jotonedev/weather-station/pictures/air-sensor-box/PXL_20260928_095529061.webp

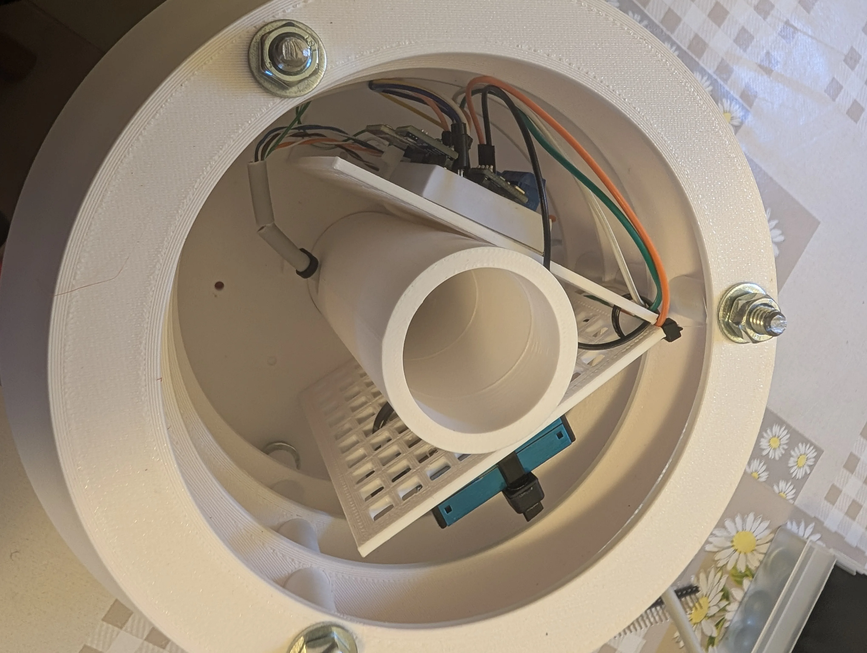
pictures/air-sensor-box/PXL_20260928_095529061.webp
