jotonedev/weather-station/pictures/rain-gauge/PXL_20260929_161344346.webp

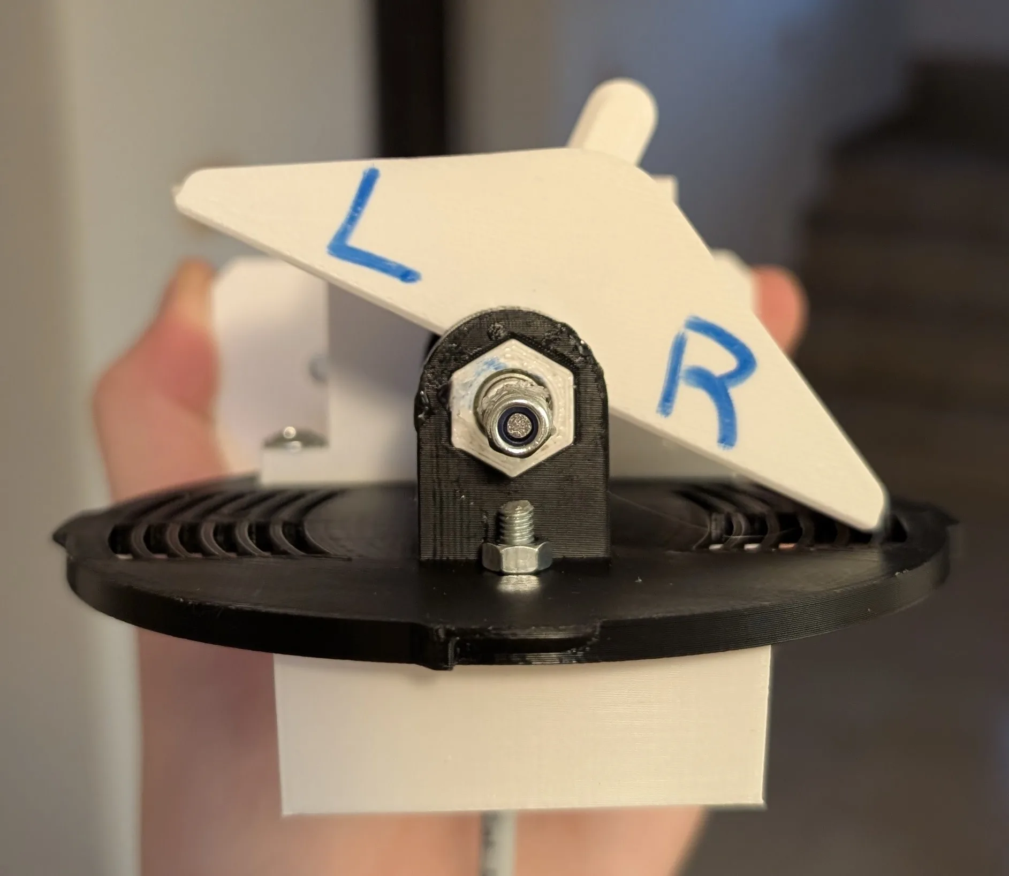
pictures/rain-gauge/PXL_20260929_161344346.webp
