jotonedev/weather-station/3dmodels/air-sensor-box/README.md

Remix of https://www.printables.com/model/1007462-sensor-community-airrohr-stevenson-screen
