jotonedev/weather-station/pictures/air-sensor-box/PXL_20260925_132656194.webp

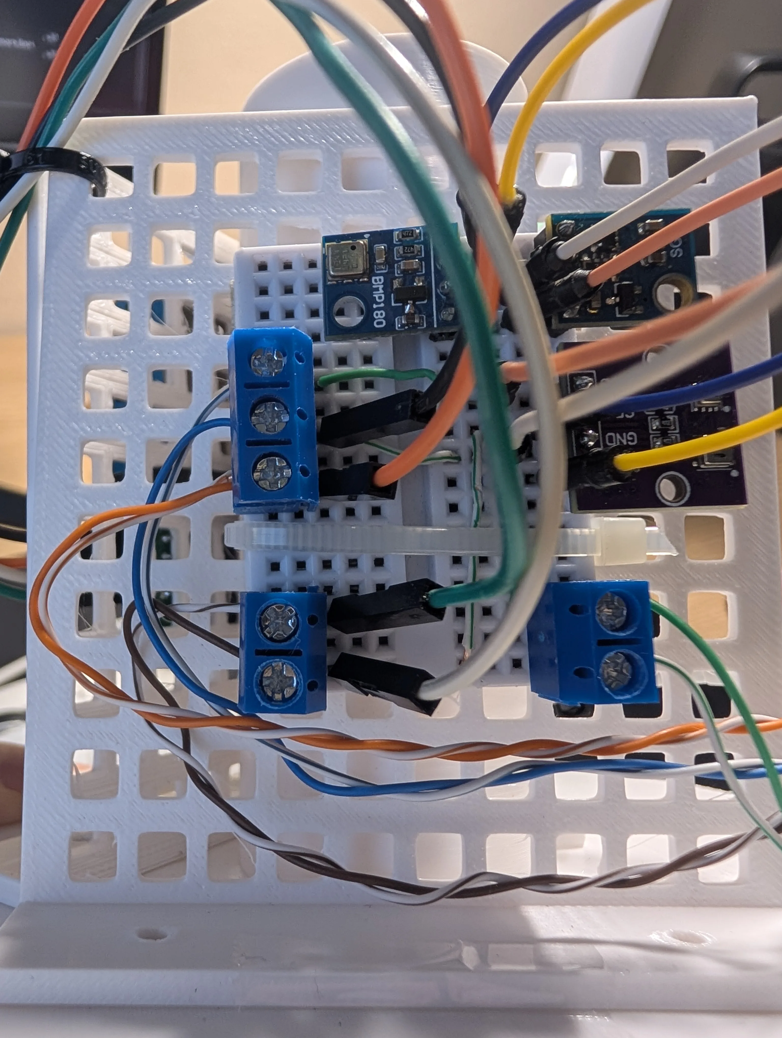
pictures/air-sensor-box/PXL_20260925_132656194.webp
