jotonedev/weather-station/pictures/air-sensor-box/PXL_20260928_095535636.webp

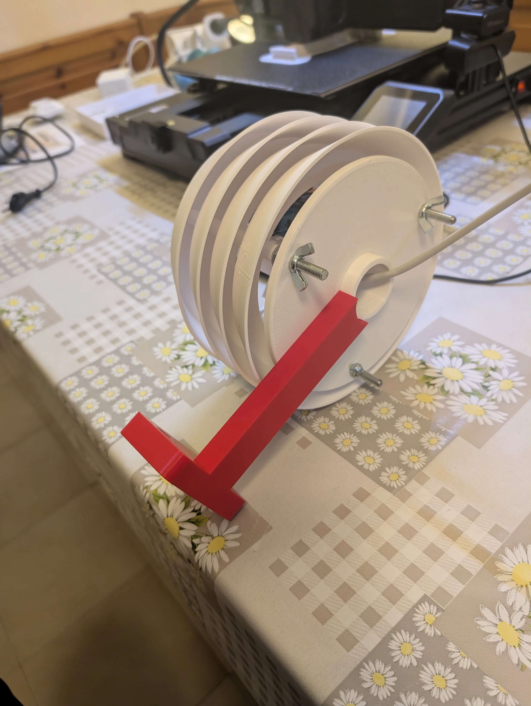
pictures/air-sensor-box/PXL_20260928_095535636.webp
