jotonedev/weather-station/pictures/anemometer-windvane/PXL_20260923_092408373.webp

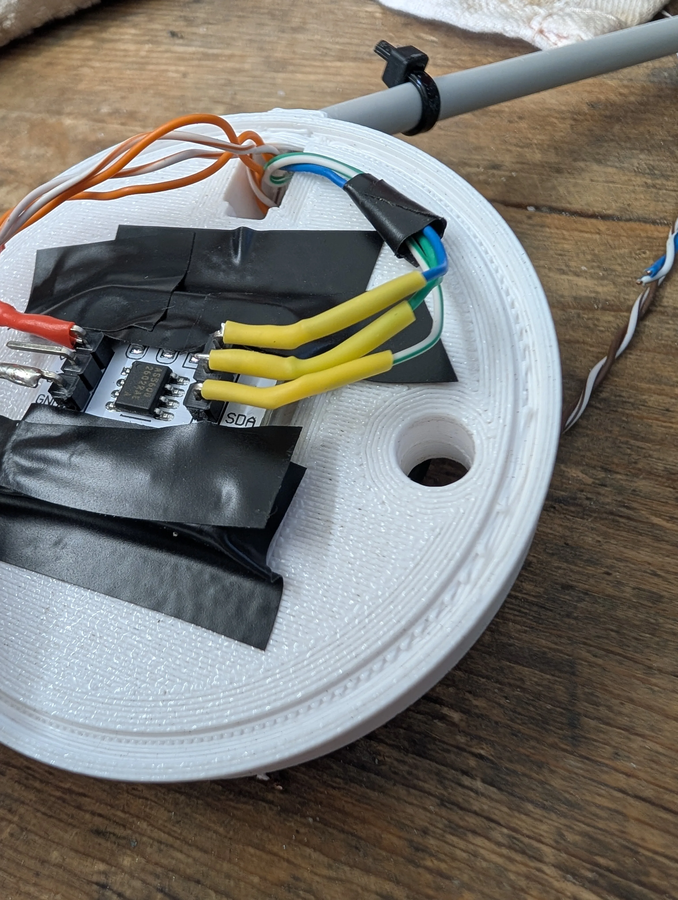
pictures/anemometer-windvane/PXL_20260923_092408373.webp
