jotonedev/weather-station/pictures/anemometer-windvane/PXL_20260928_095719903.webp

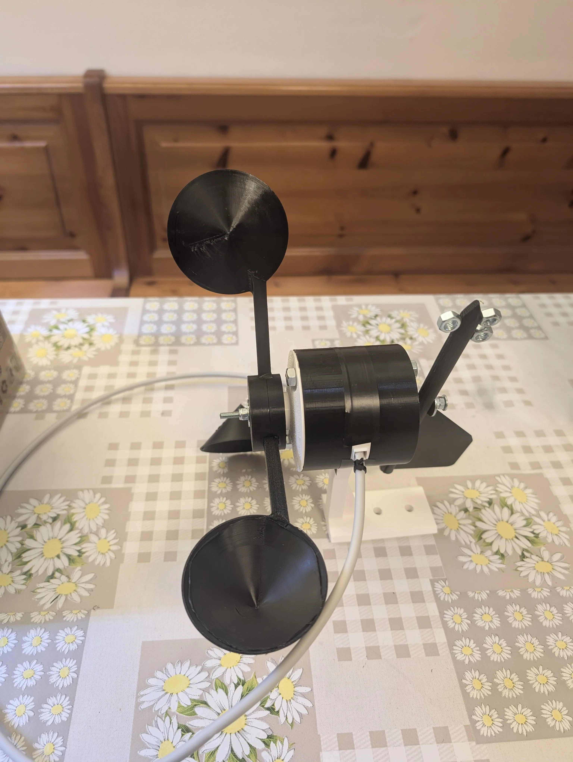
pictures/anemometer-windvane/PXL_20260928_095719903.webp
