jotonedev/weather-station/pictures/rain-gauge/PXL_20260929_145509552.webp

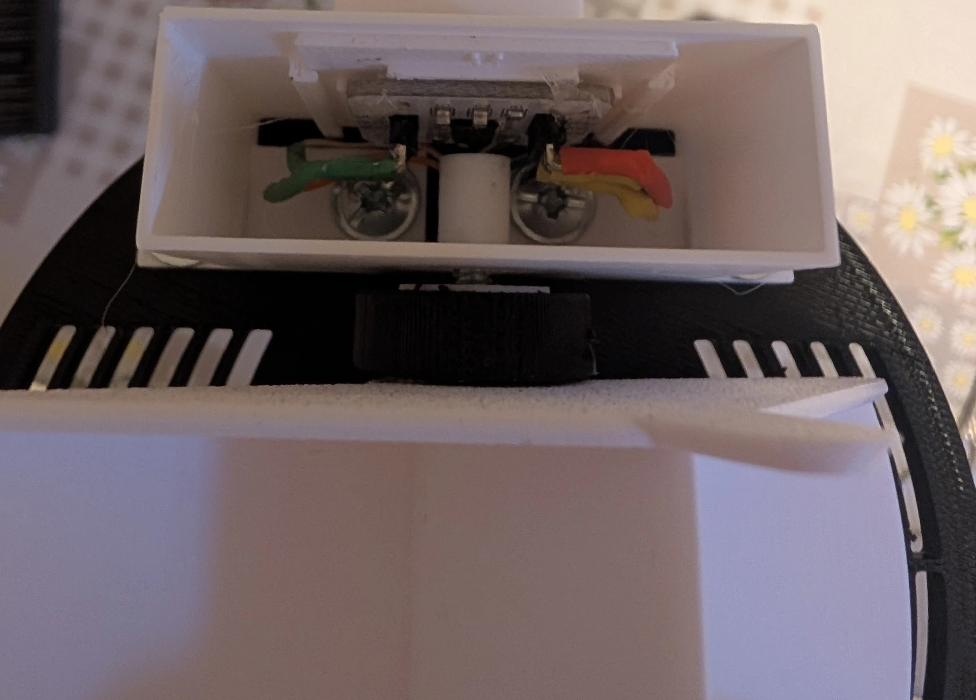
pictures/rain-gauge/PXL_20260929_145509552.webp
