jotonedev/weather-station/pictures/rain-gauge/PXL_20260929_161341023.webp

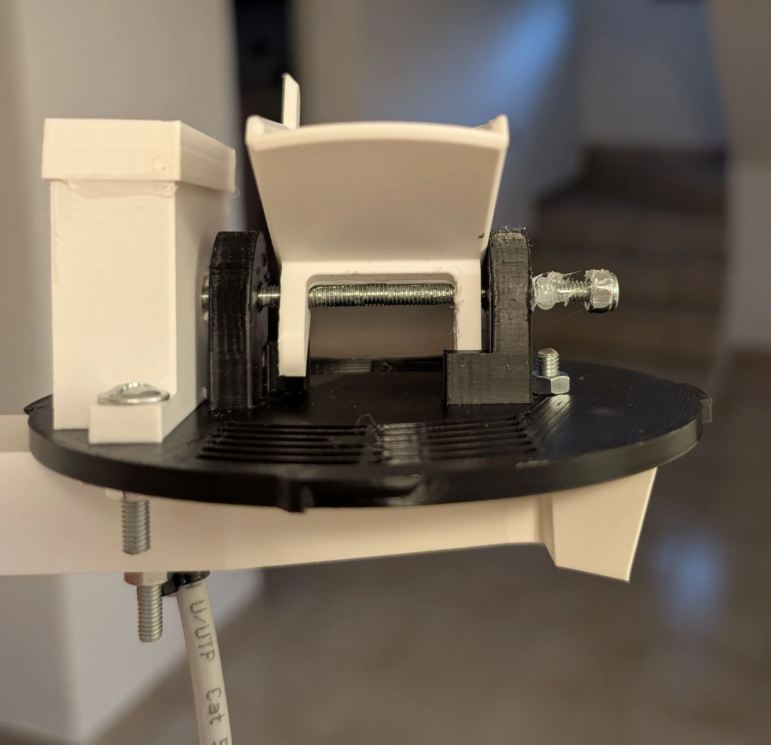
pictures/rain-gauge/PXL_20260929_161341023.webp
