jotonedev/weather-station/pictures/web-interface/homepage-01.webp

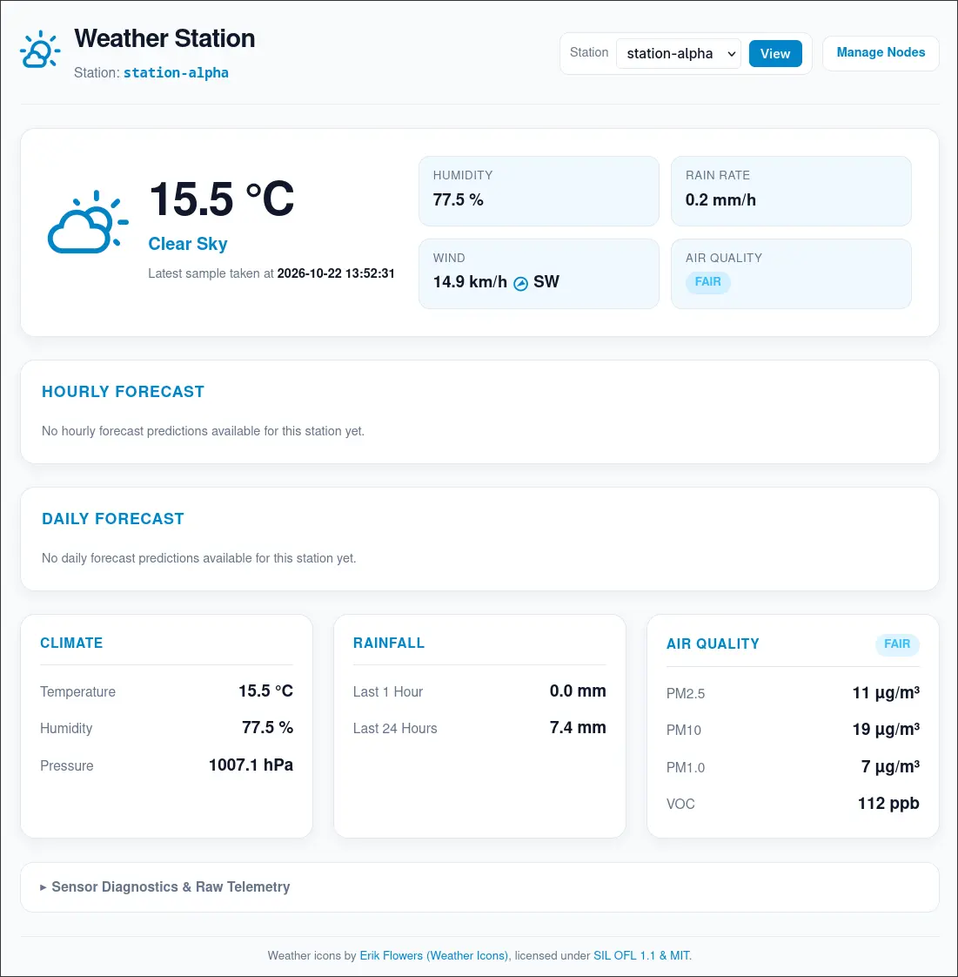
pictures/web-interface/homepage-01.webp
