jotonedev/weather-station/3dmodels/air-sensor-box/air-sensor-box.3mf

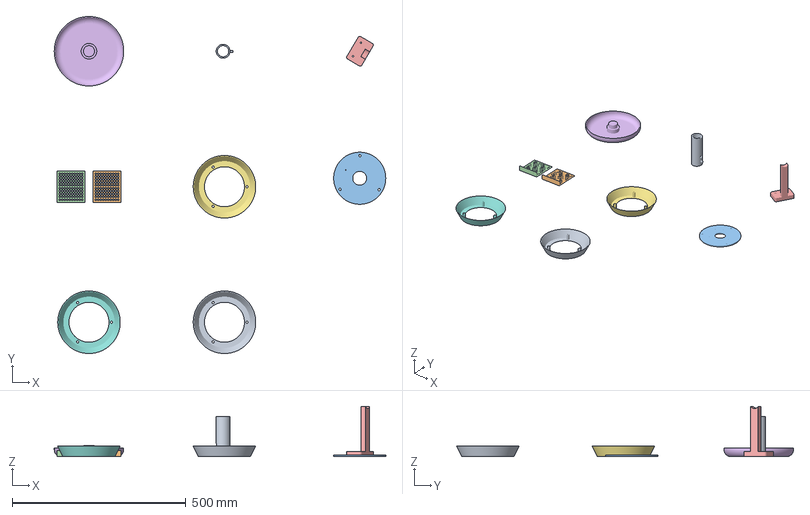
[picture p10: CAD file, 2026-10-08]
3dmodels/air-sensor-box/air-sensor-box.3mf
954.2 x 970.0 x 144.7 mm
airrohr-case-v41_airrohr-case-v41_Body7.stl
airrohr-case-v41_airrohr-case-v41_Body15.stl x 2
Body35.stl
airrohr-case-v41_airrohr-case-v41_Body34.stl
Body22.stl
layer-weather-shield.stl x 3
