jotonedev/weather-station/3dmodels/air-sensor-box/stl/air sensor box_air sensor box_wall_3_Body1.stl

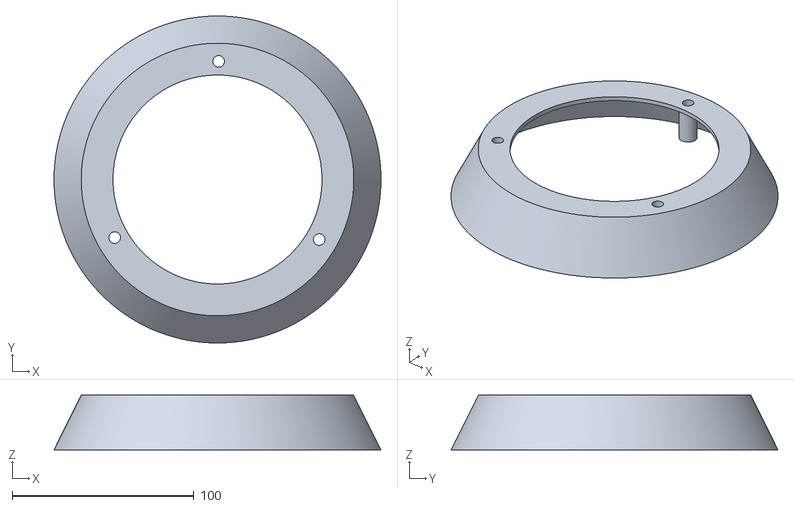
[picture p11: CAD file, 2026-10-08]
3dmodels/air-sensor-box/stl/air sensor box_air sensor box_wall_3_Body1.stl
180.0 x 180.0 x 30.0
