jotonedev/weather-station/3dmodels/anemometer-windvane/anemometer-windvane.3mf

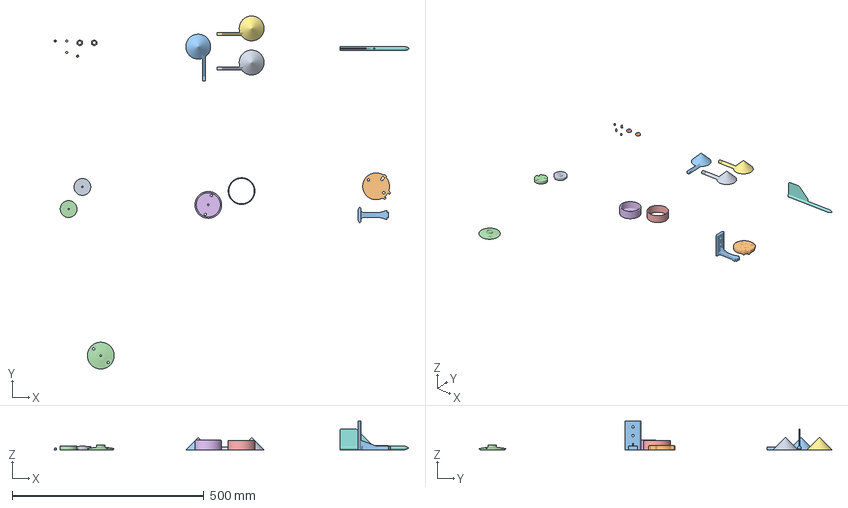
[picture p12: CAD file, 2026-10-08]
3dmodels/anemometer-windvane/anemometer-windvane.3mf
925.8 x 921.3 x 75.0 mm
Anemometre+Girouette_Anemometre+Girouette_anemometro_1_Support Helice Inf_1_Support Helice Inf.stl
Anemometre+Girouette_Anemometre+Girouette_base_1_Liaison Centrale.stl
Anemometre+Girouette_Anemometre+Girouette_supporto_1_Body1.stl
Anemometre+Girouette_Anemometre+Girouette_anemometro_1_Anemometre - Couvercle Sup_1_Anemometre - Couvercle Sup.stl
Anemometre - boitier.stl
Girouette - boitier.stl
Coupelle Conique.stl x 3
Anemometre+Girouette_Anemometre+Girouette_banderuola_1_Girouette - Corps 2_1_Girouette - Corps 2.stl
Anemometre+Girouette_Anemometre+Girouette_banderuola_1_Cage roulement ajustée_1_Body1.stl
Anemometre+Girouette_Anemometre+Girouette_anemometro_1_Support Helice Sup_1_Support Helice Sup.stl
Anemometre+Girouette_Anemometre+Girouette_anemometro_1_Cage roulement ajustée_2_Body1.stl
supporto magnete.stl x 2
Anemometre+Girouette_Anemometre+Girouette_anemometro_1_spacer_3_Body1.stl
Anemometre+Girouette_Anemometre+Girouette_banderuola_1_spacer_4_Body1.stl
