jotonedev/weather-station/3dmodels/anemometer-windvane/stl/Anemometer_Anemometer_anemometro_1_Support Helice Sup_1_Support Helice Sup.stl

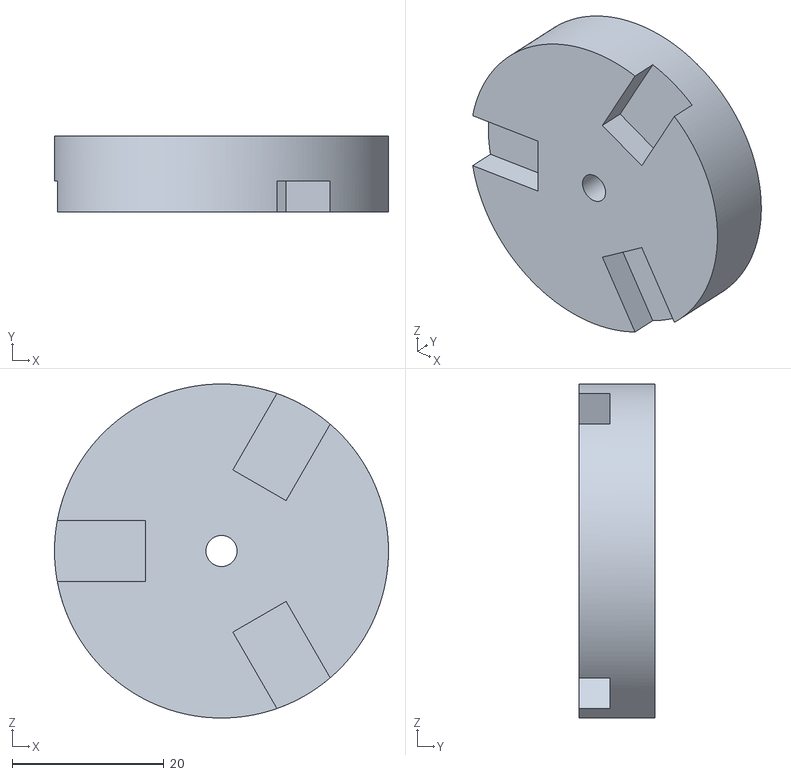
[picture p13: CAD file, 2026-10-08]
3dmodels/anemometer-windvane/stl/Anemometer_Anemometer_anemometro_1_Support Helice Sup_1_Support Helice Sup.stl
44.0 x 10.0 x 44.0
