jotonedev/weather-station/3dmodels/rain-gauge/rain-gauge.3mf

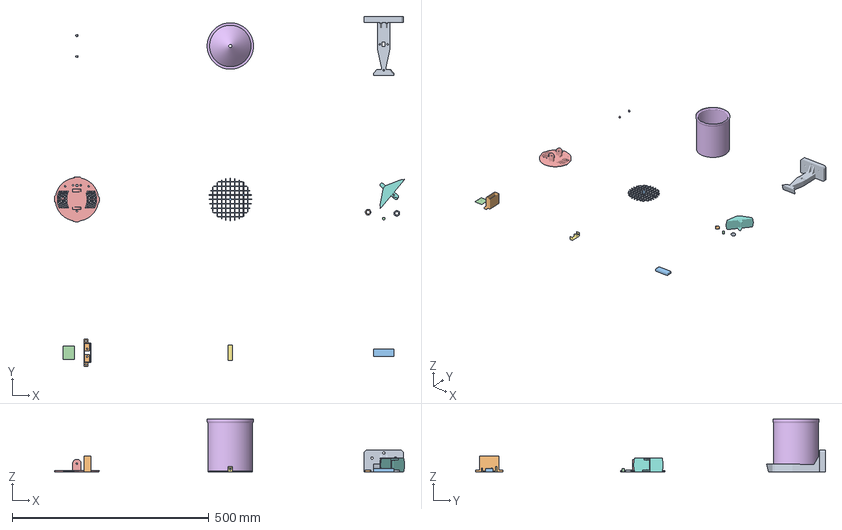
[picture p14: CAD file, 2026-10-08]
3dmodels/rain-gauge/rain-gauge.3mf
889.8 x 890.2 x 134.0 mm
Support.stl
walls.stl
cap.stl
as5600.stl
fixture.stl x 2
Body12.stl
Tipping bucket.stl
Body2.stl x 2
Mesh.stl
supporto magnete.stl
Base.stl
Case.stl
