jotonedev/weather-station/3dmodels/rain-gauge/stl/Rain gauge_Rain gauge_Roulement_1_housing.stl

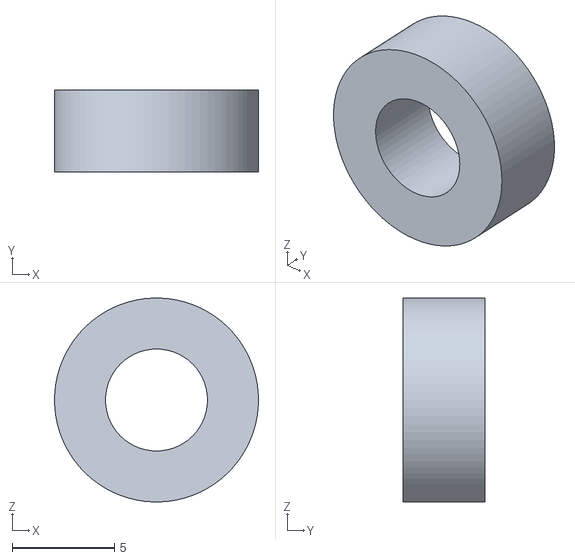
[picture p15: CAD file, 2026-10-08]
3dmodels/rain-gauge/stl/Rain gauge_Rain gauge_Roulement_1_housing.stl
10.0 x 4.00 x 9.99
