jotonedev/weather-station/3dmodels/air-sensor-box/stl/air sensor box_air sensor box_sensor-support_2_sensor-support.stl

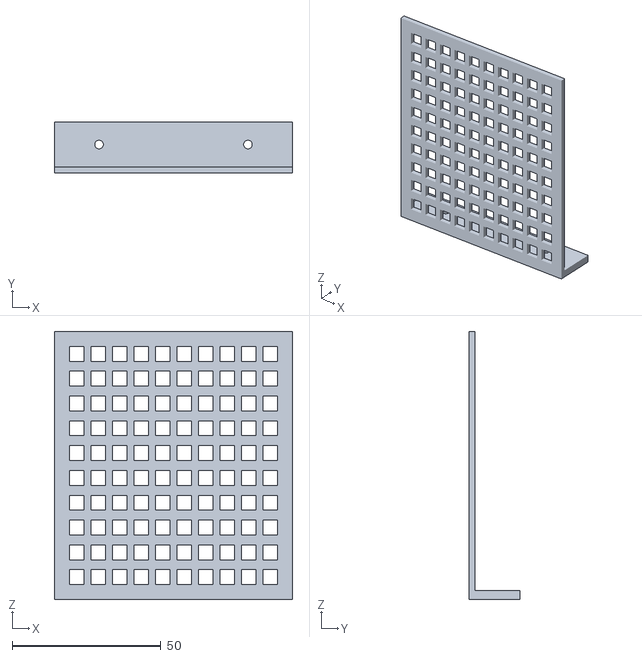
[picture p16: CAD file, 2026-10-08]
3dmodels/air-sensor-box/stl/air sensor box_air sensor box_sensor-support_2_sensor-support.stl
80.0 x 17.0 x 90.0
