jotonedev/weather-station/3dmodels/anemometer-windvane/stl/Anemometer_Anemometer_barre filettate_1_Body2.stl

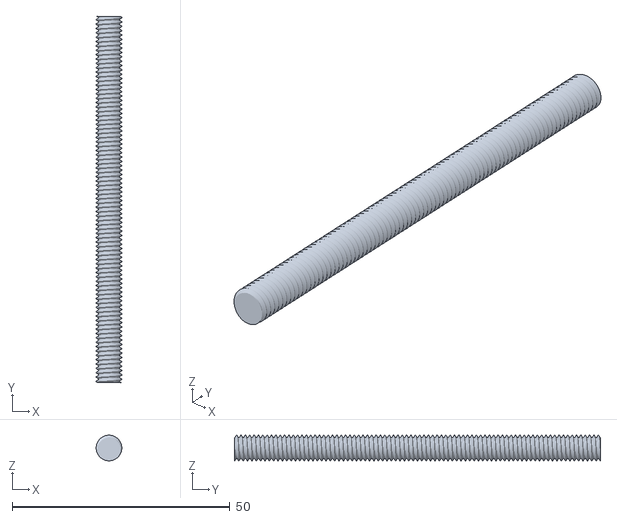
[picture p17: CAD file, 2026-10-08]
3dmodels/anemometer-windvane/stl/Anemometer_Anemometer_barre filettate_1_Body2.stl
5.88 x 84.0 x 5.88
