jotonedev/weather-station/3dmodels/rain-gauge/stl/Rain gauge_Rain gauge_Support_1_Base.stl

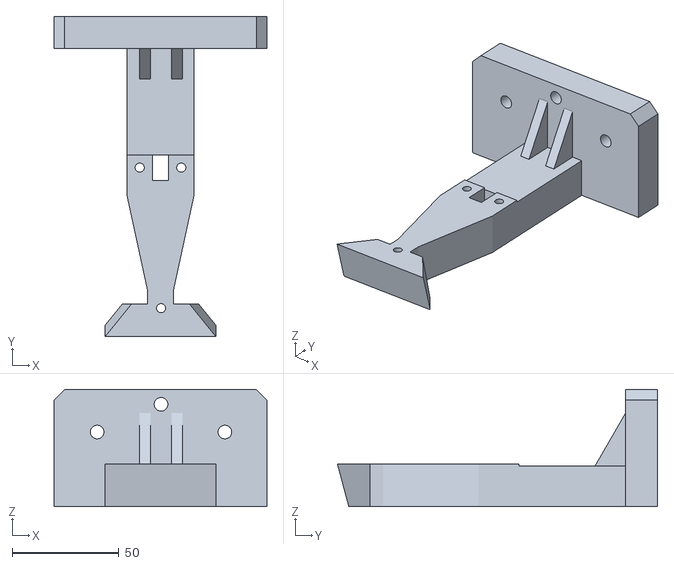
[picture p18: CAD file, 2026-10-08]
3dmodels/rain-gauge/stl/Rain gauge_Rain gauge_Support_1_Base.stl
100.0 x 150.4 x 55.0
