jotonedev/weather-station/3dmodels/air-sensor-box/stl/air sensor box_air sensor box_core_1_Body1.stl

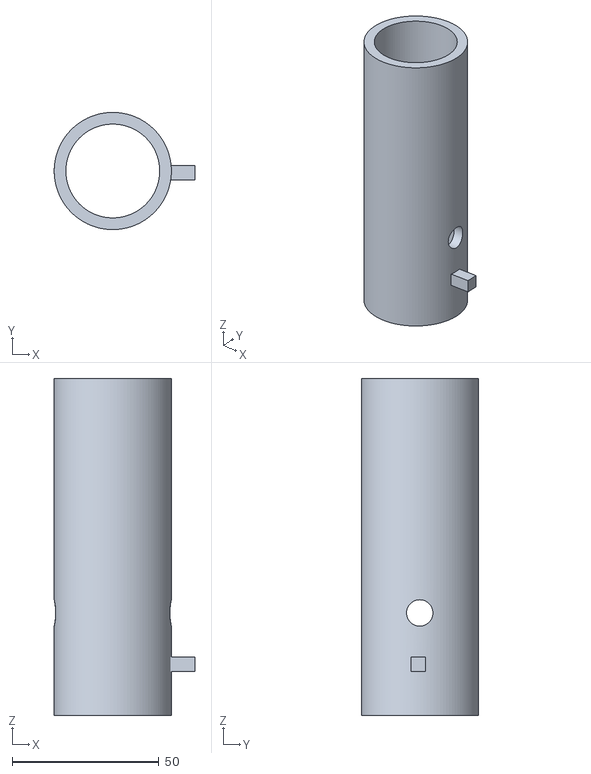
[picture p19: CAD file, 2026-10-08]
3dmodels/air-sensor-box/stl/air sensor box_air sensor box_core_1_Body1.stl
48.0 x 40.0 x 115.0
