jotonedev/weather-station/3dmodels/anemometer-windvane/stl/Anemometer_Anemometer_anemometro_1_Cage roulement ajustée_2_Body1.stl

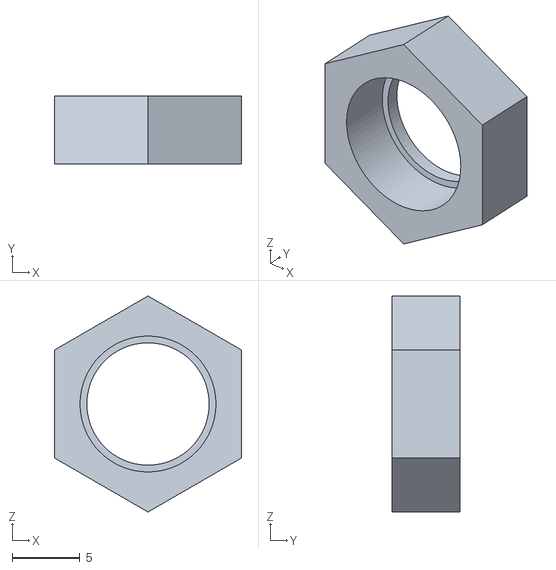
[picture p20: CAD file, 2026-10-08]
3dmodels/anemometer-windvane/stl/Anemometer_Anemometer_anemometro_1_Cage roulement ajustée_2_Body1.stl
13.8 x 5.00 x 15.9
