jotonedev/weather-station/3dmodels/anemometer-windvane/stl/Anemometer_Anemometer_anemometro_1_supporto magnete_1_Body1.stl

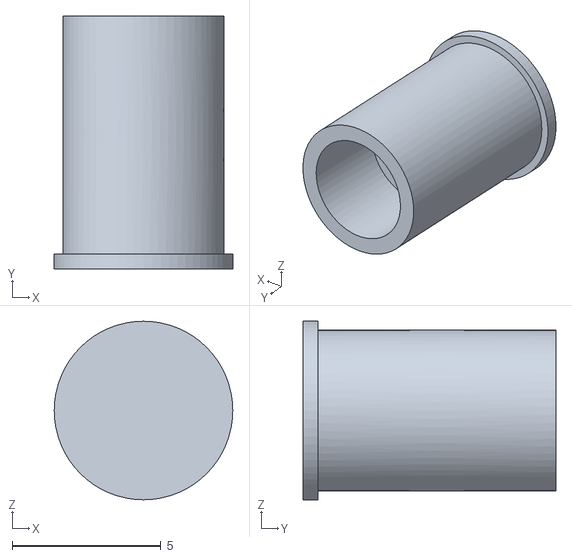
[picture p21: CAD file, 2026-10-08]
3dmodels/anemometer-windvane/stl/Anemometer_Anemometer_anemometro_1_supporto magnete_1_Body1.stl
6.00 x 8.50 x 6.00
