jotonedev/weather-station/3dmodels/rain-gauge/stl/Rain gauge_Rain gauge_Electronic box_1_walls.stl

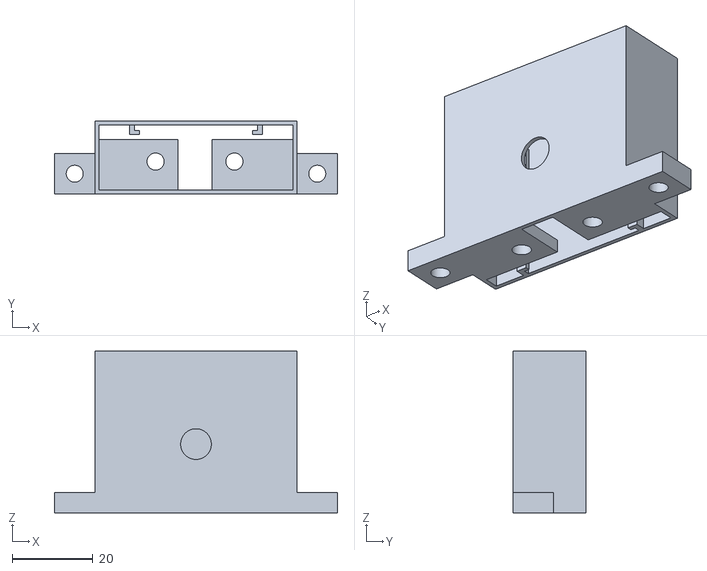
[picture p22: CAD file, 2026-10-08]
3dmodels/rain-gauge/stl/Rain gauge_Rain gauge_Electronic box_1_walls.stl
70.0 x 18.0 x 40.0
