jotonedev/weather-station/3dmodels/anemometer-windvane/stl/Anemometer_Anemometer_supporto_1_Body1.stl

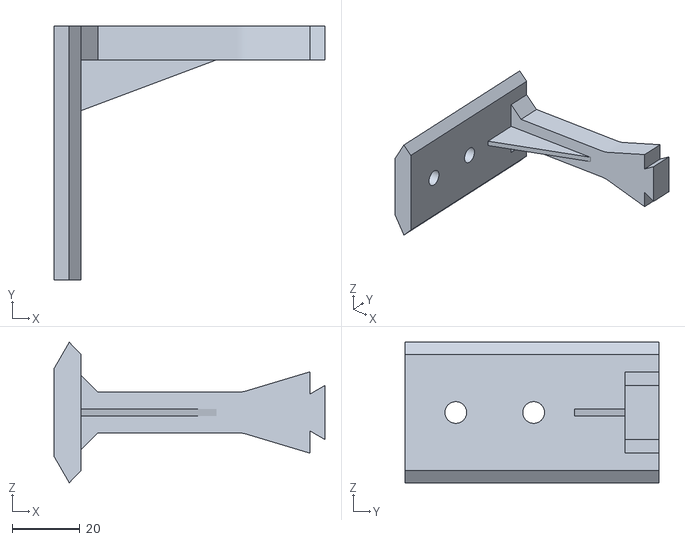
[picture p23: CAD file, 2026-10-08]
3dmodels/anemometer-windvane/stl/Anemometer_Anemometer_supporto_1_Body1.stl
80.0 x 75.0 x 41.5
