jotonedev/weather-station/3dmodels/rain-gauge/stl/Rain gauge_Rain gauge_Roulement_2_fixture.stl

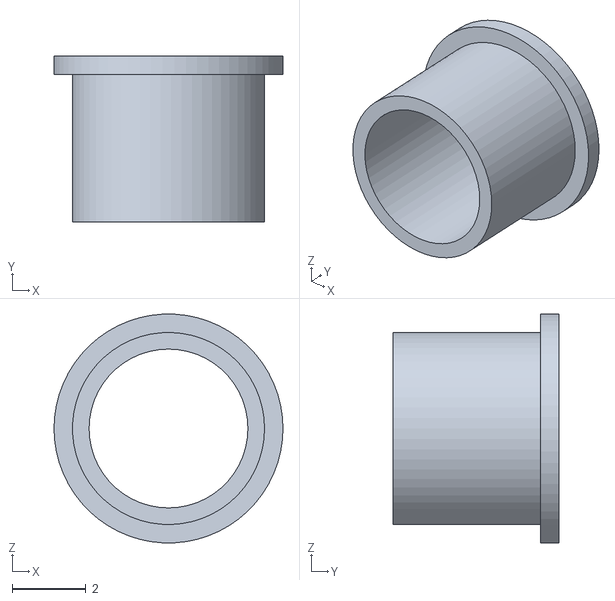
[picture p24: CAD file, 2026-10-08]
3dmodels/rain-gauge/stl/Rain gauge_Rain gauge_Roulement_2_fixture.stl
6.20 x 4.50 x 6.19
