jotonedev/weather-station/3dmodels/air-sensor-box/stl/air sensor box_air sensor box_base_1_base.stl

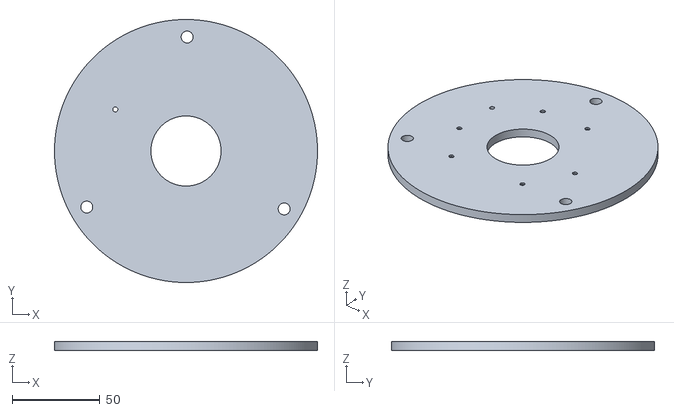
[picture p25: CAD file, 2026-10-08]
3dmodels/air-sensor-box/stl/air sensor box_air sensor box_base_1_base.stl
150.0 x 150.0 x 5.00
