jotonedev/weather-station/3dmodels/anemometer-windvane/stl/Anemometer_Anemometer_anemometro_1_Coupelle Conique_3_Body1.stl

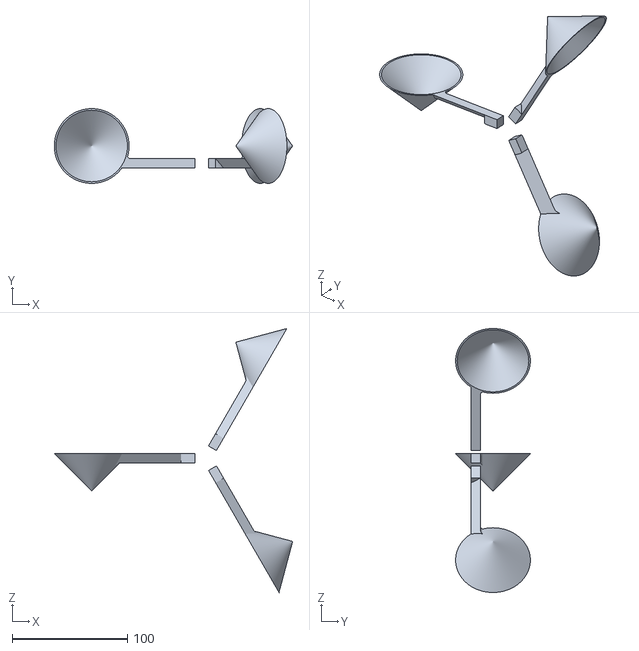
[picture p26: CAD file, 2026-10-08]
3dmodels/anemometer-windvane/stl/Anemometer_Anemometer_anemometro_1_Coupelle Conique_3_Body1.stl
207.2 x 65.0 x 229.5
