jotonedev/weather-station/3dmodels/air-sensor-box/stl/air sensor box_air sensor box_support_1_support.stl

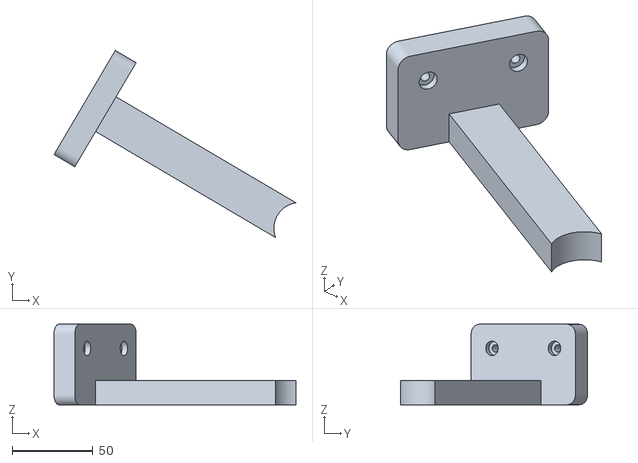
[picture p27: CAD file, 2026-10-08]
3dmodels/air-sensor-box/stl/air sensor box_air sensor box_support_1_support.stl
150.2 x 116.2 x 50.0
