jotonedev/weather-station/3dmodels/anemometer-windvane/stl/Anemometer_Anemometer_anemometro_1_Anemometre - Couvercle Sup_1_Anemometre - Couvercle Sup.stl

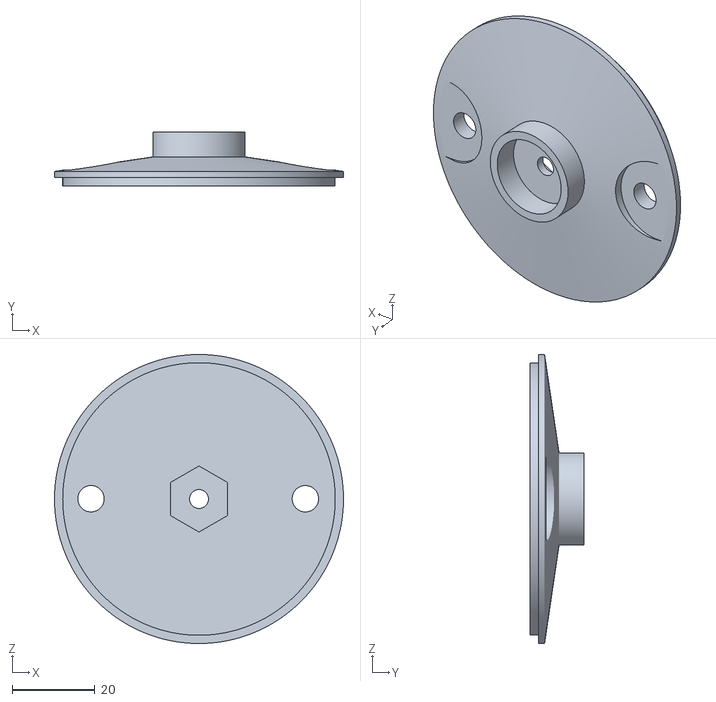
[picture p28: CAD file, 2026-10-08]
3dmodels/anemometer-windvane/stl/Anemometer_Anemometer_anemometro_1_Anemometre - Couvercle Sup_1_Anemometre - Couvercle Sup.stl
70.0 x 13.0 x 70.0
