jotonedev/weather-station/3dmodels/rain-gauge/stl/Rain gauge_Rain gauge_supporto magnete_1_Body1.stl

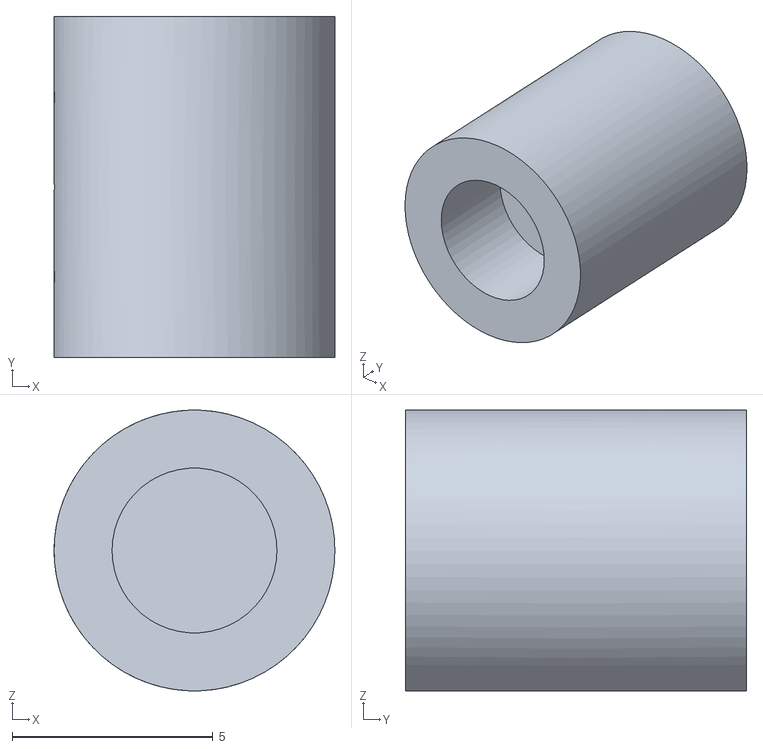
[picture p29: CAD file, 2026-10-08]
3dmodels/rain-gauge/stl/Rain gauge_Rain gauge_supporto magnete_1_Body1.stl
7.00 x 8.50 x 7.00
