jotonedev/weather-station/3dmodels/anemometer-windvane/stl/Anemometer_Anemometer_banderuola_1_Girouette - boitier_1_Girouette - boitier.stl

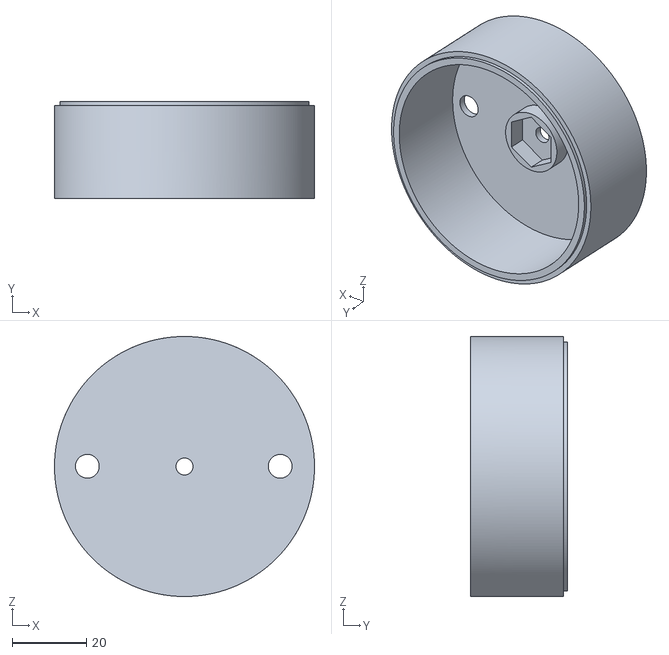
[picture p30: CAD file, 2026-10-08]
3dmodels/anemometer-windvane/stl/Anemometer_Anemometer_banderuola_1_Girouette - boitier_1_Girouette - boitier.stl
70.0 x 26.0 x 70.0
