jotonedev/weather-station/3dmodels/rain-gauge/stl/Rain gauge_Rain gauge_Axe 4mm_1_Body2.stl

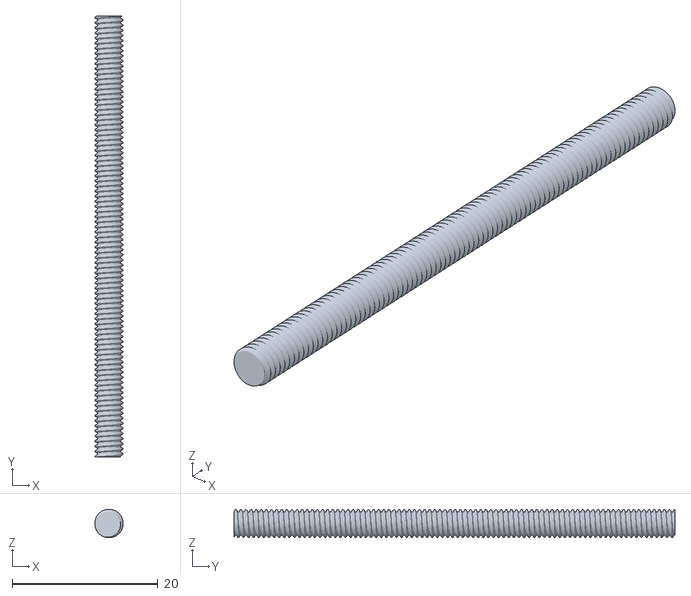
[picture p31: CAD file, 2026-10-08]
3dmodels/rain-gauge/stl/Rain gauge_Rain gauge_Axe 4mm_1_Body2.stl
3.91 x 60.5 x 3.91
