jotonedev/weather-station/3dmodels/anemometer-windvane/stl/Anemometer_Anemometer_banderuola_1_Girouette - Corps 2_1_Girouette - Corps 2.stl

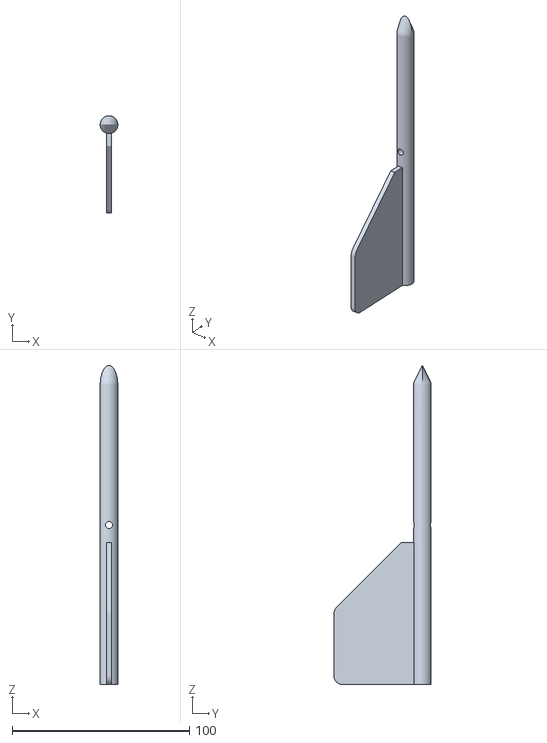
[picture p32: CAD file, 2026-10-08]
3dmodels/anemometer-windvane/stl/Anemometer_Anemometer_banderuola_1_Girouette - Corps 2_1_Girouette - Corps 2.stl
9.98 x 55.0 x 180.0
