jotonedev/weather-station/3dmodels/rain-gauge/stl/Rain gauge_Rain gauge_Electronic box_1_cap.stl

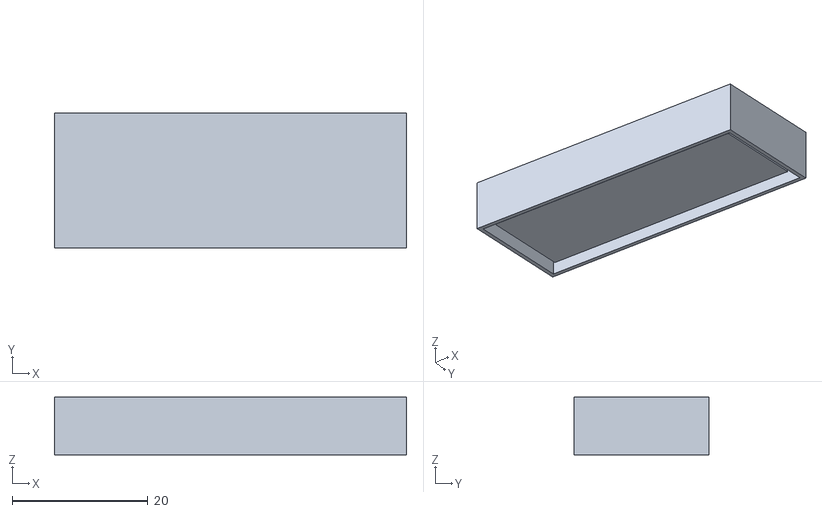
[picture p33: CAD file, 2026-10-08]
3dmodels/rain-gauge/stl/Rain gauge_Rain gauge_Electronic box_1_cap.stl
51.8 x 19.8 x 8.50
