jotonedev/weather-station/3dmodels/air-sensor-box/stl/air sensor box_air sensor box_cover_1_cover.stl

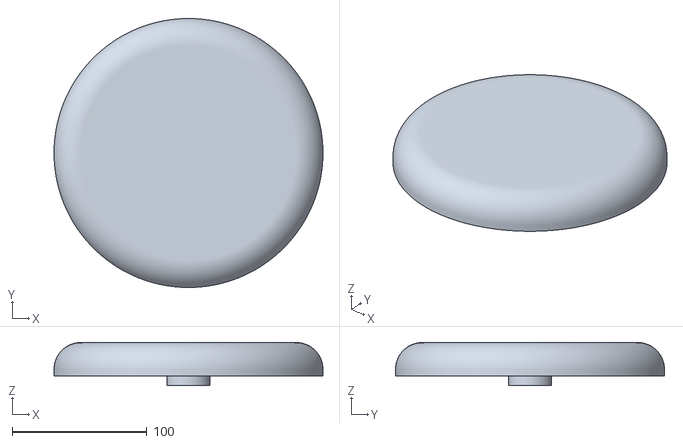
[picture p34: CAD file, 2026-10-08]
3dmodels/air-sensor-box/stl/air sensor box_air sensor box_cover_1_cover.stl
200.0 x 200.0 x 32.0
