jotonedev/weather-station/3dmodels/rain-gauge/stl/Rain gauge_Rain gauge_Base_1_Body47.stl

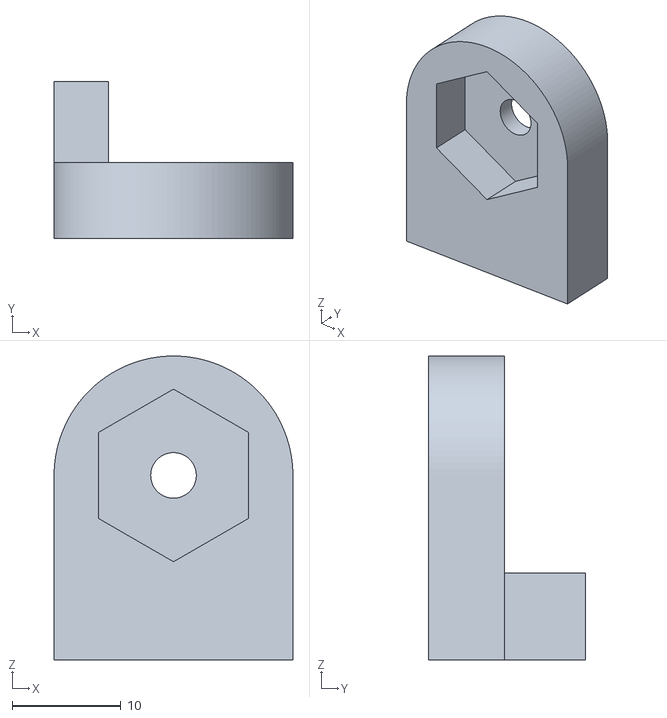
[picture p35: CAD file, 2026-10-08]
3dmodels/rain-gauge/stl/Rain gauge_Rain gauge_Base_1_Body47.stl
22.0 x 14.5 x 28.0
