jotonedev/weather-station/3dmodels/anemometer-windvane/stl/Anemometer_Anemometer_base_1_Liaison Centrale.stl

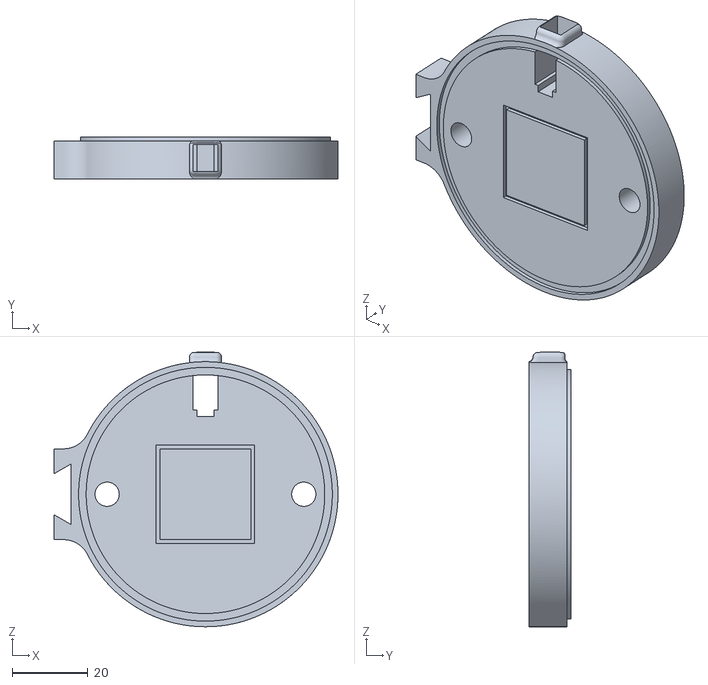
[picture p36: CAD file, 2026-10-08]
3dmodels/anemometer-windvane/stl/Anemometer_Anemometer_base_1_Liaison Centrale.stl
75.0 x 11.0 x 72.5
