jotonedev/weather-station/3dmodels/rain-gauge/stl/Rain gauge_Rain gauge_Electronic box_1_as5600.stl

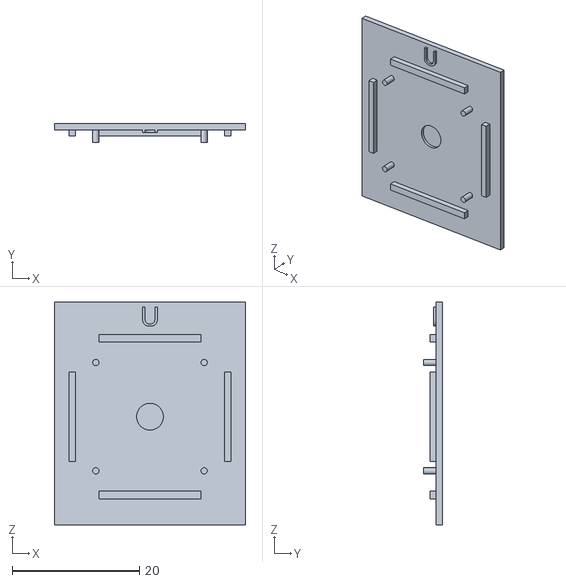
[picture p37: CAD file, 2026-10-08]
3dmodels/rain-gauge/stl/Rain gauge_Rain gauge_Electronic box_1_as5600.stl
30.0 x 3.00 x 35.0
