jotonedev/weather-station/3dmodels/anemometer-windvane/stl/Anemometer_Anemometer_banderuola_1_spacer_4_Body1.stl

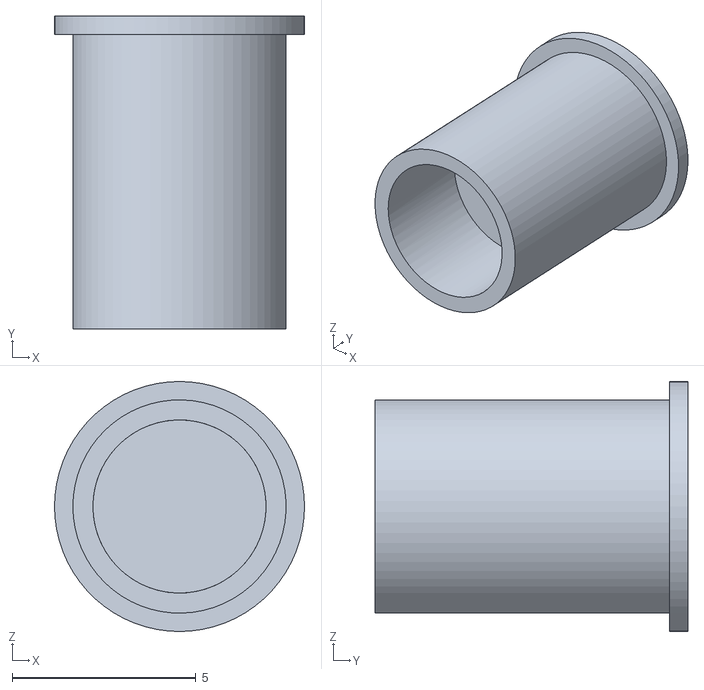
[picture p38: CAD file, 2026-10-08]
3dmodels/anemometer-windvane/stl/Anemometer_Anemometer_banderuola_1_spacer_4_Body1.stl
6.80 x 8.50 x 6.80
