jotonedev/weather-station/3dmodels/anemometer-windvane/stl/Anemometer_Anemometer_anemometro_1_Anemometre - boitier_1_Anemometre - boitier.stl

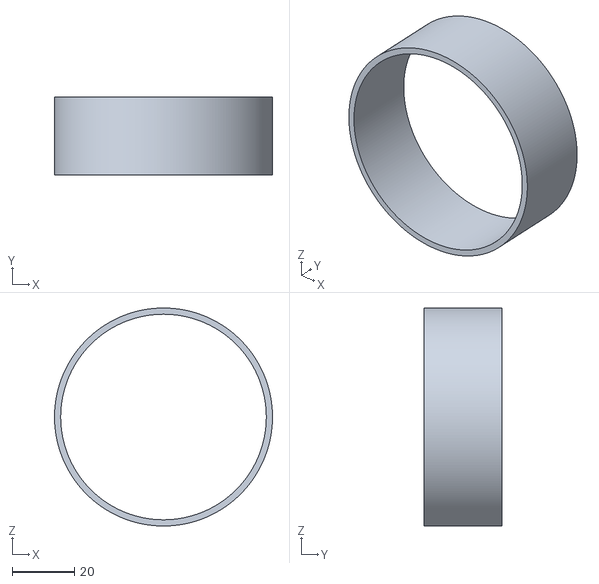
[picture p39: CAD file, 2026-10-08]
3dmodels/anemometer-windvane/stl/Anemometer_Anemometer_anemometro_1_Anemometre - boitier_1_Anemometre - boitier.stl
70.0 x 25.0 x 70.0
