jotonedev/weather-station/3dmodels/rain-gauge/stl/Rain gauge_Rain gauge_Base_1_Body3.stl

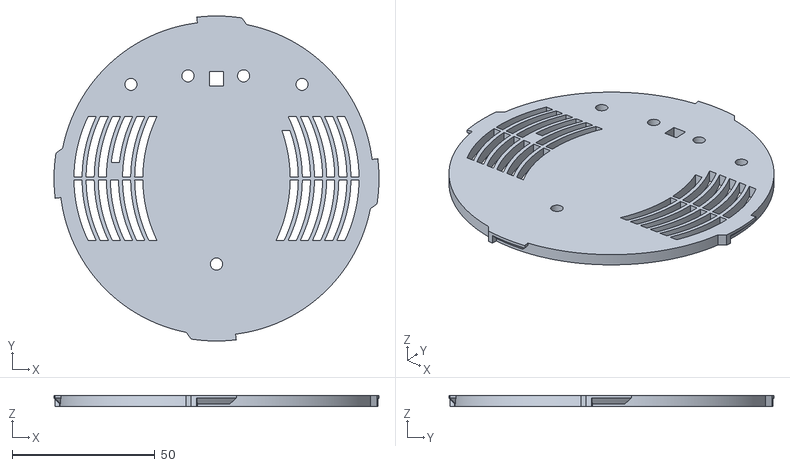
[picture p40: CAD file, 2026-10-08]
3dmodels/rain-gauge/stl/Rain gauge_Rain gauge_Base_1_Body3.stl
114.0 x 114.0 x 4.00
