jotonedev/weather-station/3dmodels/anemometer-windvane/stl/Anemometer_Anemometer_anemometro_1_Support Helice Inf_1_Support Helice Inf.stl

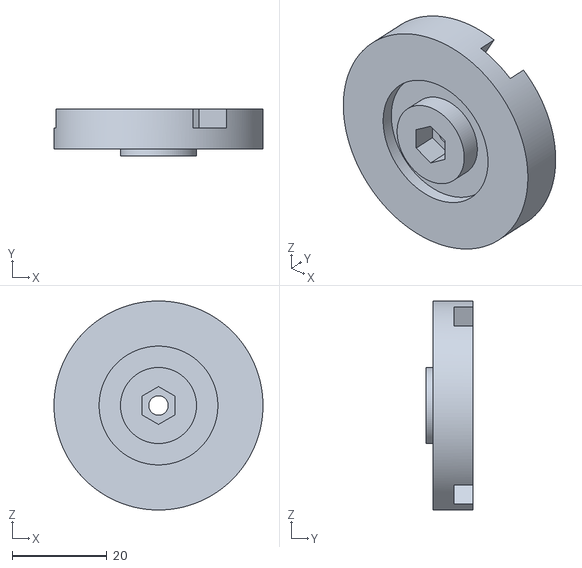
[picture p41: CAD file, 2026-10-08]
3dmodels/anemometer-windvane/stl/Anemometer_Anemometer_anemometro_1_Support Helice Inf_1_Support Helice Inf.stl
44.0 x 10.0 x 44.0
