jotonedev/weather-station/(list of files, cad)

Other CAD files:
3dmodels/rain-gauge/stl/Rain gauge_Rain gauge_Roulement_2_Body2.stl
3dmodels/air-sensor-box/stl/air sensor box_air sensor box_sensor-support_1_sensor-support.stl
3dmodels/air-sensor-box/stl/air sensor box_air sensor box_wall_2_Body1.stl
3dmodels/rain-gauge/stl/Rain gauge_Rain gauge_Roulement_1_fixture.stl
3dmodels/air-sensor-box/stl/air sensor box_air sensor box_wall_4_Body1.stl
3dmodels/air-sensor-box/stl/air sensor box_air sensor box_wall_1_Body1.stl
3dmodels/anemometer-windvane/stl/Anemometer_Anemometer_barre filettate_1_Body1.stl
3dmodels/rain-gauge/stl/Rain gauge_Rain gauge_Base_1_Body48.stl
3dmodels/anemometer-windvane/stl/Anemometer_Anemometer_anemometro_1_spacer_3_Body1.stl
3dmodels/rain-gauge/stl/Rain gauge_Rain gauge_Roulement_2_housing.stl
3dmodels/rain-gauge/stl/Rain gauge_Rain gauge_Roulement_1_Body2.stl
3dmodels/anemometer-windvane/stl/Anemometer_Anemometer_banderuola_1_Cage roulement ajustée_1_Body1.stl
3dmodels/anemometer-windvane/stl/Anemometer_Anemometer_banderuola_1_supporto magnete_2_Body1.stl
3dmodels/air-sensor-box/air sensor box.f3d
3dmodels/anemometer-windvane/anemometer-windvane.f3z
3dmodels/rain-gauge/Rain gauge.f3d
