jotonedev/weather-station/(commit log)

2026-09-25 Refactor Anemometer and WindVane classes for improved functionality and task management
    - Updated Anemometer class to include task management for background sampling.
    - Enhanced WindVane class with task management and improved angle reading logic.
    - Introduced new methods for diagnostics and sensor health telemetry in both classes.
    - Adjusted pin definitions in constants.h for better clarity and organization.
    - Modified ARQ initialization parameters for CC1101 to enhance communication reliability.
2026-09-25 Refactor WindVane task management for dynamic sample period and improved smoothing
2026-09-25 Refactor pin assignments for ESP32-S3
2026-09-25 Add rain rate and magnet status to RainData structure; refactor RainMeter class
2026-09-27 calibrate rain meter
2026-10-08 Wire up repo into controller
2026-10-10 Add weather reading ingestion flow
    Wire readings from HTTP handlers through the controller to the database gRPC gateway. Add the Reading model with JSON aliases, protobuf mapper, database config, and tests. Replace the placeholder weatherstation handler and add the OpenAPI spec.
2026-10-10 Wire up inference-job service
2026-10-12 Add gRPC health and readiness checks to microservices
    - Add readiness and health checks using grpc.health.v1 across all microservices
    - Add in-repo static healthprobe CLI tool for container healthcheck execution
    - Decouple HTTP server in database and inference-job to run solely on gRPC
    - Wire service readiness checkers for QuestDB, database, and inference-server gateways
    - Update Go and Python Dockerfiles and GitHub workflows
2026-10-12 Migrate from QuestDB to embedded DuckDB and pin database to rpi3
    - Replace QuestDB with embedded DuckDB in database service
    - Remove database/gateway and isolate DuckDB in database/client
    - Update repositories (timestorage, aggregate, nodecoords, prediction) for DuckDB
    - Pin database pod to rpi3 node using nodeSelector and toleration for dedicated=rpi3 taint
    - Configure truenas-iscsi storage class and PVC with existingClaim support
    - Update Helm chart, Dockerfile, and network policies
2026-10-12 Pin inferenceServer deployment to large nodes
    - Add nodeSelector, affinity, and tolerations support to deployment-inference-server.yaml
    - Set default nodeSelector to node-size=large (matching arm-01 and arm-02 with ~12GB RAM)
2026-10-12 Pin dataIngest to rpi3 node
    - Add nodeSelector, tolerations, and affinity support to data-ingest, frontend, and cronjob-inference
    - Pin dataIngest to rpi3 node alongside database service
2026-10-12 Remove Istio and Jaeger from Helm chart
    - Delete Istio PeerAuthentication, AuthorizationPolicy, and Telemetry templates
    - Remove istio section from values.yaml and NOTES.txt
    - Rely on native zero-overhead Kubernetes NetworkPolicies for zero-trust traffic filtering
2026-10-12 fix(docker): populate missing module go.mod checksums and set GOWORK=off in probe-builder
2026-10-12 Wire up inference job
2026-10-18 chore(deps): update actions/cache action to v6 (#5)
    This PR contains the following updates:
    | Package | Type | Update | Change |
    |---|---|---|---|
    | [actions/cache](https://github.com/actions/cache) | action | major | `v4` → `v6` |
    ---
    > ⚠️ **Warning**
    >
    > Some dependencies could not be looked up. Check the Dependency Dashboard for more information.
    ---
    ### Release Notes
    <details>
    <summary>actions/cache (actions/cache)</summary>
    ### [`v6`](https://github.com/actions/cache/compare/v5...v6)
    [Compare Source](https://github.com/actions/cache/compare/v5...v6)
    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
2026-10-18 chore(deps): update actions/checkout action to v7 (#7)
    | [actions/checkout](https://github.com/actions/checkout) | action | major | `v4` → `v7` |
    <summary>actions/checkout (actions/checkout)</summary>
    ### [`v7`](https://github.com/actions/checkout/blob/HEAD/CHANGELOG.md#v701)
    [Compare Source](https://github.com/actions/checkout/compare/v6...v7)
    - Skip running unsafe pr check if input is default by [@&#8203;aiqiaoy](https://github.com/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
2026-10-18 chore(deps): update actions/setup-go action to v7 (#8)
    | [actions/setup-go](https://github.com/actions/setup-go) | action | major | `v5` → `v7` |
    <summary>actions/setup-go (actions/setup-go)</summary>
    ### [`v7`](https://github.com/actions/setup-go/compare/v6...v7)
    [Compare Source](https://github.com/actions/setup-go/compare/v6...v7)
    ### [`v6`](https://github.com/actions/setup-go/compare/v5...v6)
    [Compare Source](https://github.com/ac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
2026-10-18 chore(deps): update actions/setup-node action to v7 (#9)
    | [actions/setup-node](https://github.com/actions/setup-node) | action | major | `v4` → `v7` |
    <summary>actions/setup-node (actions/setup-node)</summary>
    ### [`v7`](https://github.com/actions/setup-node/compare/v6...v7)
    [Compare Source](https://github.com/actions/setup-node/compare/v6...v7)
    ### [`v6`](https://github.com/actions/setup-node/compare/v5...v6)
    [Compare Source](https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
2026-10-18 chore(deps): update astral-sh/setup-uv action to v7 (#10)
    | [astral-sh/setup-uv](https://github.com/astral-sh/setup-uv) | action | major | `v5` → `v7` |
    <summary>astral-sh/setup-uv (astral-sh/setup-uv)</summary>
    ### [`v7`](https://github.com/astral-sh/setup-uv/compare/v6...v7)
    [Compare Source](https://github.com/astral-sh/setup-uv/compare/v6...v7)
    ### [`v6`](https://github.com/astral-sh/setup-uv/compare/v5...v6)
    [Compare Source](http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
2026-10-18 chore(deps): update azure/setup-helm action to v5 (#11)
    | [azure/setup-helm](https://github.com/azure/setup-helm) | action | major | `v4` → `v5` |
    <summary>azure/setup-helm (azure/setup-helm)</summary>
    ### [`v5`](https://github.com/azure/setup-helm/compare/v4...v5)
    [Compare Source](https://github.com/azure/setup-helm/compare/v4...v5)
    </details>
    ### Configuration
    📅 **Schedule**: Branch creation - At any time (no schedule defi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
2026-10-18 chore(deps): update dependency node to v24 (#12)
    | [node](https://github.com/actions/node-versions) | uses-with | major | `20` → `24` |
    <summary>actions/node-versions (node)</summary>
    ### [`v24.22.0`](https://github.com/actions/node-versions/releases/tag/24.22.0-38668177966): 24.22.0
    [Compare Source](https://github.com/actions/node-versions/compare/24.21.0-34304089047...24.22.0-38668177966)
    Node.js 24.22.0
    ### [`v24.21.0`](https://gi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
2026-10-18 fix(deps): update module github.com/marcboeker/go-duckdb to v2 (#13)
    | Package | Change | [Age](https://docs.renovatebot.com/merge-confidence/) | [Confidence](https://docs.renovatebot.com/merge-confidence/) |
    | [github.com/marcboeker/go-duckdb](https://github.com/marcboeker/go-duckdb) | `v1.8.5` → `v2.4.3` | ![age](https://developer.mend.io/api/mc/badges/age/go/github.com%2fmarcboeker%2fgo-duckdb/v2.4.3?slim=true) | ![confidence](https://developer.mend.io/api/mc/badges/confidence/go/github.com%2fmarcboeker%2fgo-duckdb/v1.8.5/v2.4.3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) |
    > Some dependencies could not be looked up. Check the Depen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
2026-10-19 fix(ci,deploy): sha- prefix for image tags and keel match-tag digest tracking
    Keel's force-policy multi-tag watcher treats any tag different from the
    current one as a valid update candidate when the current tag is
    non-semver (e.g. latest), so bare short-SHA tags could get pinned and
    roll back to stale/broken builds (observed with 105b913).
    - prefix SHA tags with sha- so they are never semver-parseable
    - add keel.sh/match-tag=true so Keel tracks only the digest of the tag
    in use (single-tag watcher) and updates on digest change
2026-10-20 fix(inference-server): harden observation validation and imputation
    Treat non-finite sensor values as missing data so a NaN never reaches the
    model. Required columns above the 30 percent effective missing ratio are
    rejected, sparse gaps are interpolated, and over-long gaps keep a constant
    plateau instead of one straight line. Remove silent zero-fill and fail
    loudly if imputation leaves non-finite values.
    Model pressure as an optional variate instead of validating it and
    discarding it. Drop the wind forecast path, which production never sends
    and no consumer reads. Remove the unused data_blob packing in
    inference-job to avoid duplicate serialization per request.
2026-10-20 [skip ci] chore(deps): update docker/setup-qemu-action action to v4 (#14)
    | [docker/setup-qemu-action](https://github.com/docker/setup-qemu-action) | action | major | `v3` → `v4` |
    <summary>docker/setup-qemu-action (docker/setup-qemu-action)</summary>
    ### [`v4`](https://github.com/docker/setup-qemu-action/compare/v3...v4)
    [Compare Source](https://github.com/docker/setup-qemu-action/compare/v3...v4)
    ### Configuration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
2026-10-20 Pin uv version on workflow
2026-10-20 Wire up mcus
2026-10-20 [mcu] Optimize control node reliability and power consumption
2026-10-20 [mcu] Improve base station reliability and power efficiency
2026-10-20 Update actions/setup-python action to v7 (#20)
    | [actions/setup-python](https://github.com/actions/setup-python) | action | major | `v6` → `v7` |
    <summary>actions/setup-python (actions/setup-python)</summary>
    ### [`v7`](https://github.com/actions/setup-python/compare/v6...v7)
    [Compare Source](https://github.com/actions/setup-python/compare/v6...v7)
    📅 **Schedule**: Branch creation - At any time (n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
2026-10-21 Add calibration mode on control node
2026-10-22 Stack daily forecast max and min temperatures on separate lines
2026-10-22 Handle downtime holes and align hourly predictions to hour boundary
2026-10-22 Fix daily prediction insert placeholder count and deduplicate forecasts
    Correct insertDailyPredictionSQL to use nine value placeholders matching the schema columns. Clear existing prediction batches for the same issue timestamp before inserting to ensure idempotent retries. Add qualify clauses to latest prediction queries to collapse duplicate horizon rows. Update test generator authentication in Helm values.
2026-10-29 Update dependency node to v26 (#25)
    | [node](https://github.com/actions/node-versions) | uses-with | major | `24` → `26` |
    ### [`v26.13.0`](https://github.com/actions/node-versions/releases/tag/26.13.0-40806794713): 26.13.0
    [Compare Source](https://github.com/actions/node-versions/compare/26.12.1-39618969937...26.13.0-40806794713)
    Node.js 26.13.0
    ### [`v26.12.1`](https://github.com/acti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
2026-11-05 Display forecast bands, pressure, and rain probability and clean up frontend views
2026-11-05 Calibrate rain probability and use median rainfall in inference-server
2026-11-05 Remove forecast pressure, fit temperature on one line, and show all daily cards
2026-11-06 Pin index page
2026-11-09 Update power modes for AS5600 in anemometer, rainmeter, and windvane classes
2026-11-09 Remove VOC measurements to reduce power consumption
2026-11-09 Adjust slow filter setting for AS5600 in Anemometer to improve noise suppression
2026-11-09 Configure automatic light sleep in control node to reduce power consumption
2026-11-09 Optimize AS5600 polling and diagnostic intervals to reduce power consumption
